Ezkeisac/chrome-subwoofer/README-chrome-draft.md

The chrome cabinet in the studio, a monitor standing on it

# DIY chrome subwoofer bc Everything is chrome in the future

Building a subwoofer for my home studio. A ten-inch driver, a sealed cabinet, a mirror
finish, a monitor base.

**318 × 661 × 280 mm · $380**

Turn it. Switch to wireframe. There is no bracing.

```stl
solid enclosure
  facet normal 0.0000 0.0000 -1.0000
    outer loop
      vertex 128.50 -171.50 0.00
      vertex 159.00 -128.90 0.00
      vertex 159.00 -171.50 0.00
    endloop
  endfacet
  facet normal 0.0000 0.0000 -1.0000
    outer loop
      vertex 128.50 -171.50 0.00
      vertex 124.12 -138.24 0.00
      vertex 159.00 -128.90 0.00
    endloop
  endfacet
  facet normal 0.0000 0.0000 -1.0000
    outer loop
      vertex 124.12 -138.24 0.00
      vertex 159.00 -79.70 0.00
      vertex 159.00 -128.90 0.00
    endloop
  endfacet
  facet normal 0.0000 0.0000 -1.0000
    outer loop
      vertex 124.12 -138.24 0.00
      vertex 111.28 -107.25 0.00
      vertex 159.00 -79.70 0.00
    endloop
  endfacet
  facet normal 0.0000 0.0000 -1.0000
    outer loop
      vertex 111.28 -107.25 0.00
      vertex 159.00 -12.50 0.00
      vertex 159.00 -79.70 0.00
    endloop
  endfacet
  facet normal 0.0000 0.0000 -1.0000
    outer loop
      vertex 111.28 -107.25 0.00
      vertex 90.86 -80.64 0.00
      vertex 159.00 -12.50 0.00
    endloop
  endfacet
  facet normal 0.0000 0.0000 -1.0000
    outer loop
      vertex 90.86 -80.64 0.00
      vertex 159.00 103.90 0.00
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

MDF is porous and its routed edges more so. Unsealed, it absorbs unevenly and telegraphs
its fibre through any film laid over it. Each coat fills that structure. Each sanding
removes what the coat raised. What remains is flat, sealed and non-absorbent.

The cabinet after priming and before vinyl: white primer on the sides, bare MDF on the baffle around the rebated aperture

Preparation is the operation. The wrap is the short step at the end: VViViD DECO65, cut
from the roll in pieces and fitted at the joints.

On a specular finish a seam is permanent. On a corner, where the surface already turns
away, it reads as an edge. Forty millimetres onto a flat face, the same seam reads as a
defect.

</details>

<details open>
<summary>The shape</summary>

A monitor stands on it. That fixed the footprint before any acoustic decision was made,
and left height as the only dimension free to solve.

An enclosure normally begins with a volume and arrives at proportions. This one runs the
other way. The footprint fixes the cross-section. **The shape leads and the volume must
follow.** Two dimensions imposed, one to solve.

The answer is a column more than twice as tall as it is wide. The same volume, unconstrained,
is a cube.

The footprint here is a Realistic Nova 7B's. Another monitor is another footprint, and
the height is solved again.

```bash
python3 calculations/derive_box.py
```

</details>

<details>
<summary>What you need</summary>

| | | |
|---|---|---:|
| GRS 10SW-4HE | 10-inch subwoofer, 4 ohm | $61.98 |
| MDF panel × 2 | 3/4 in × 4 ft × 8 ft | $97.96 |
| SPA300-D | 300 W plate amplifier | $167.98 |
| VViViD DECO65 | chrome vinyl, 20 ft × 11.8 in | $11.98 |
| RCA Y cable | subwoofer feed | $7.99 |
| Speaker wire | 16 AWG, 9.14 m | $9.95 |
| | **Total** | **$357.84** |

Fasteners, adhesive, primer and sealant are not costed.

Hand-held power tools, a compact router on a circle-cutting jig, clamps. No table saw. No
router table.

| | mm | in |
|---|---:|---:|
| External width × height × depth | 318 × 661 × 280 | 12.52 × 26.02 × 11.02 |
| Internal width × height × depth | 280 × 623 × 242 | 11.02 × 24.53 × 9.53 |
| Wall thickness | 19 | 0.75 |
| Driver flange diameter | 257 | 10.12 |
| Rebate depth | 6 | 0.24 |
| Through-hole diameter | 233 | 9.17 |

</details>

<details>
<summary>The cabinet</summary>

**Wear respiratory and eye protection throughout. MDF dust is a recognised hazard.**

Two sheets of 19 mm MDF. Set out the driver aperture with a pivot and rule. Cut it with
the router on the circle jig.

The driver aperture marked on the baffle, with the pivot at its centre, before routing

Rebate the aperture: a shallow shoulder concentric with the through-hole, so the 257 mm
flange seats flush. A jigsaw gives neither the radius nor the shoulder.

Glue and clamp the joints for **72 hours**. A sealed alignment is valid only if the
enclosure is airtight, and at this panel size a joint left to cure under its own weight
will creep.

**No internal bracing.** `DISCUSSION.md` §6.2 establishes that none is required.

</details>

<details>
<summary>The hook-up</summary>

The receiver's rear panel as wired, with the subwoofer on the SUB WOOFER RCA output

Drive it from the receiver's SUB WOOFER output. **That places two low-pass filters in
series**, the receiver's and the plate amplifier's, and their slopes sum. What is
measured here is the pair.

The pair is fourth order, −3 dB at 57 Hz, measured. The amplifier's dial deconvolves to
about 62 Hz against a target of 60, if the receiver's fixed stage is second order at
90 Hz. The manual gives the frequency and not the slope.

Two sources, two inputs. The DJ controller on CD. The record player on DVD.

The receiver is wired for more than it is asked. Mains on FRONT A, two surrounds, a booth
monitor on CENTER, the subwoofer on SUB WOOFER. With processing off, a stereo source
reaches the mains and the subwoofer and nothing else. In an upmixing mode the receiver
spreads either input across every channel, and the bass it redirects reaches the
subwoofer by a route not measured here.

</details>

<details>
<summary>The sound</summary>

**39.09 L · 36.2 Hz predicted · Q 0.799 predicted**

Q sweep: the response curve rising into its peak as the handle travels 0.50 to 1.20

<!-- To replace the animation with a real video: generate an .mp4, then drag it into
     any GitHub comment box or the README web editor. GitHub returns a signed asset URL
     and inserts the tag for you. The URL is not a committed file and cannot be written
     from a script, which is why the GIF is the default here.
<video src="https://github.com/user-attachments/assets/REPLACE-ME" autoplay loop muted playsinline></video>
-->

A sealed enclosure is a second-order high-pass. Two numbers govern it:

$$H(s) = \frac{s^{2}}{s^{2} + \dfrac{s}{Q_{tc}} + 1}$$

The handle runs 0.50 to 1.20. Butterworth is the tick at 0.707: maximally flat,
*F*<sub>3</sub> exactly at *F*<sub>c</sub>. This build is the tick at a predicted
**0.799**. It peaks before it rolls off.

That was accepted, not corrected. A small room adds low-frequency gain of its own, and a
gently rolling response meets that gain more predictably than a flat anechoic one.

```bash
python3 scripts/model.py selftest
python3 scripts/sweep_qtc.py
```

</details>

<details>
<summary>How it was measured</summary>

<picture>
  <source media="(prefers-color-scheme: dark)" srcset="images/response-dark.svg">
  Measured response against the sealed-alignment prediction and the filter chain, 12 to 200 Hz
</picture>

Prediction and measurement agree to **3.65 dB** mean absolute error over 20–80 Hz. The box
model and the filter chain together agree to **1.19 dB** over 45–110 Hz.

Stepped sine, not a sweep. Playback and capture ran on separate devices sharing no clock,
and a sweep assumes the two can be aligned in time. Each tone is an independent
observation at a frequency known exactly. There is no timeline for drift to corrupt.

The instrument is an uncalibrated recorder. Every curve here is **relative**. Spectral
shape is available. Absolute sound pressure is not.

`scripts/METHOD.md` carries the window lengths, the manifest, the single-bin extraction
and the two alignment failures that produced it.

```bash
python3 scripts/analyse_response.py selftest
```

</details>

<details>
<summary>What is still unexplained</summary>

Between 32 and 56 Hz, measurement exceeds prediction by about 3 dB. Three candidates: the
published Thiele–Small parameters do not describe this specimen; boundary reinforcement,
the cabinet being against a wall; or non-flat microphone response.

**None is eliminated by the present data.** The residual is a maximum centred near
*F*<sub>c</sub>, not a monotonic rise toward low frequency, which weakly favours the first
without establishing it.

The driver parameters were never measured. That is the first thing to do differently.

</details>

---

The record: [`RECORD.txt`](RECORD.txt)

Documentation CC BY-SA 4.0, code MIT — [`LICENSE`](LICENSE).
