Ezkeisac/chrome-subwoofer/images/finished-in-situ.jpeg

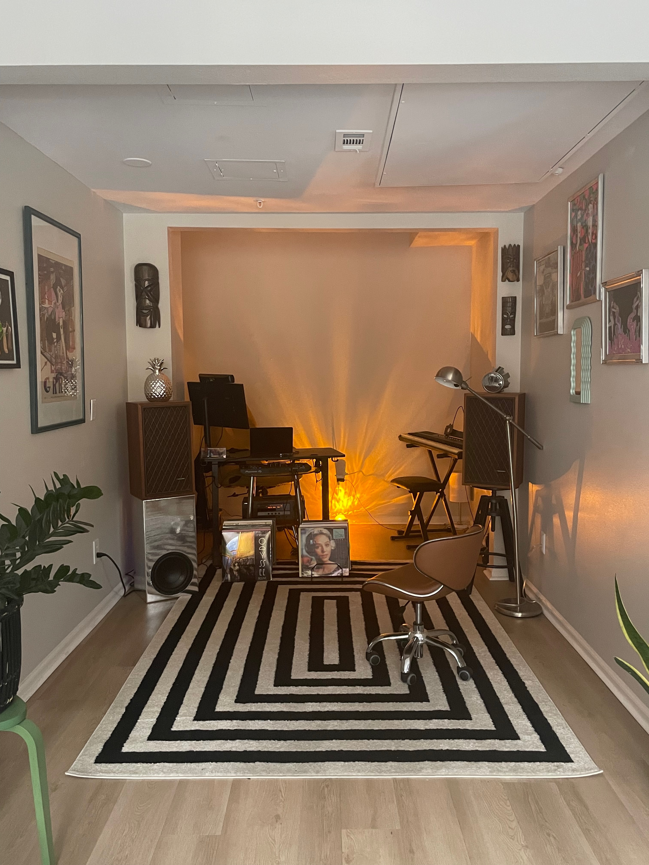
images/finished-in-situ.jpeg
