Ezkeisac/chrome-subwoofer/images/receiver-rear.jpeg

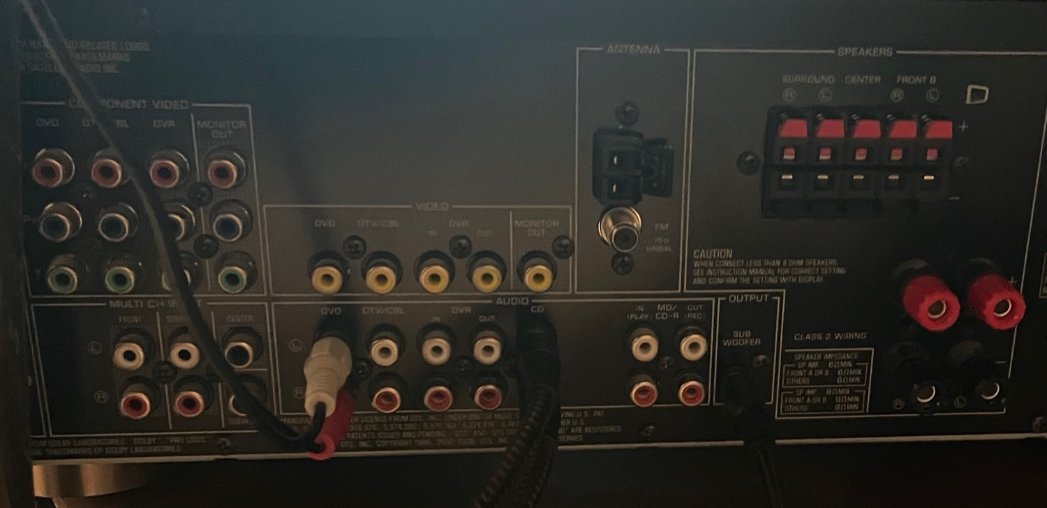
images/receiver-rear.jpeg
