Ezkeisac/chrome-subwoofer/calculations/materials-cost.csv

item | description | quantity | unit_price_usd | ext_price_usd
GRS 10SW-4HE | 10 inch subwoofer 4 ohm | 1 | 61.98 | 61.98
MDF panel | MDF 3/4 in x 4 ft x 8 ft | 2 | 48.98 | 97.96
SPA300-D | 300 W plate amplifier | 1 | 167.98 | 167.98
VViViD DECO65 | chrome vinyl 20 ft x 11.8 in | 1 | 11.98 | 11.98
RCA Y cable | subwoofer feed | 1 | 7.99 | 7.99
Speaker wire | 16 AWG 9.14 m | 1 | 9.95 | 9.95
