Ezkeisac/chrome-subwoofer/images/enclosure.stl

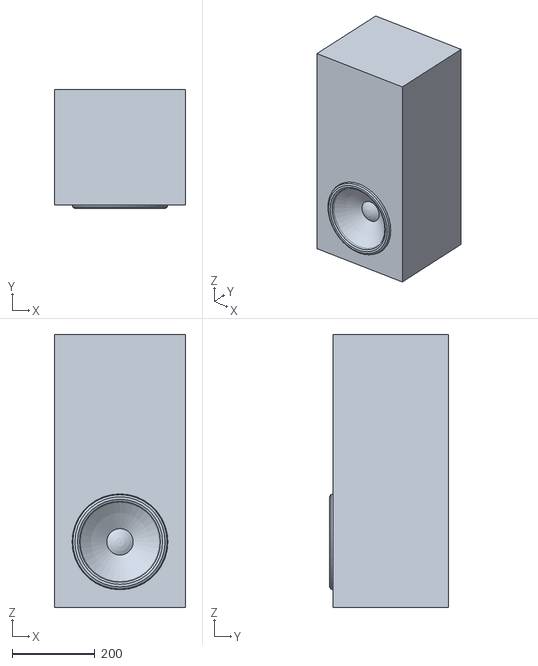
[picture p9: CAD file, 2026-11-07]
images/enclosure.stl
318.0 x 288.6 x 661.0
