Ezkeisac/chrome-subwoofer/images/construction-marking.jpeg

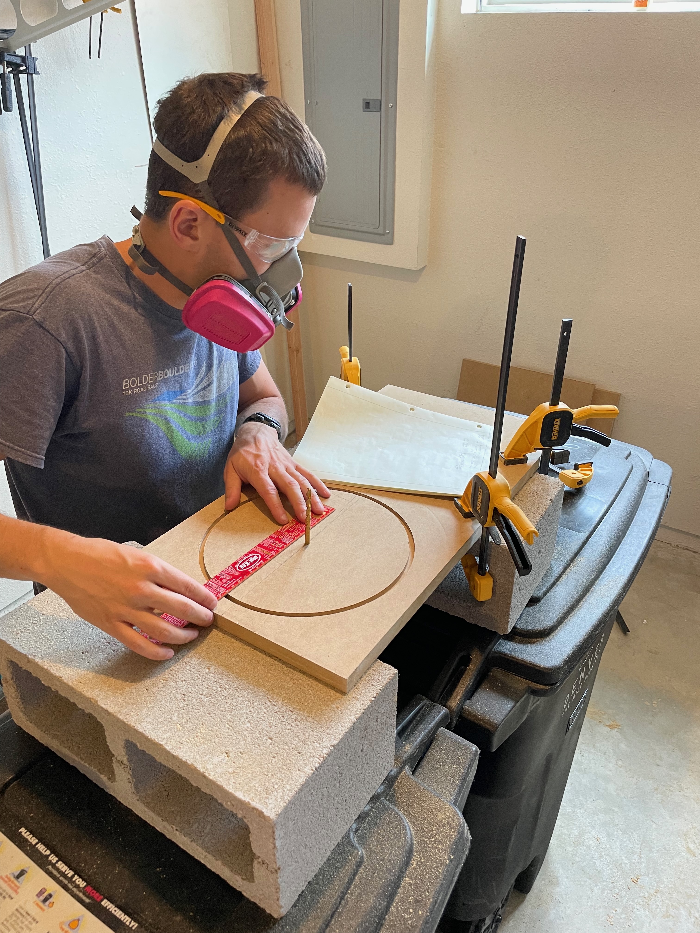
images/construction-marking.jpeg
