Ezkeisac/chrome-subwoofer/images/construction-routing.jpeg

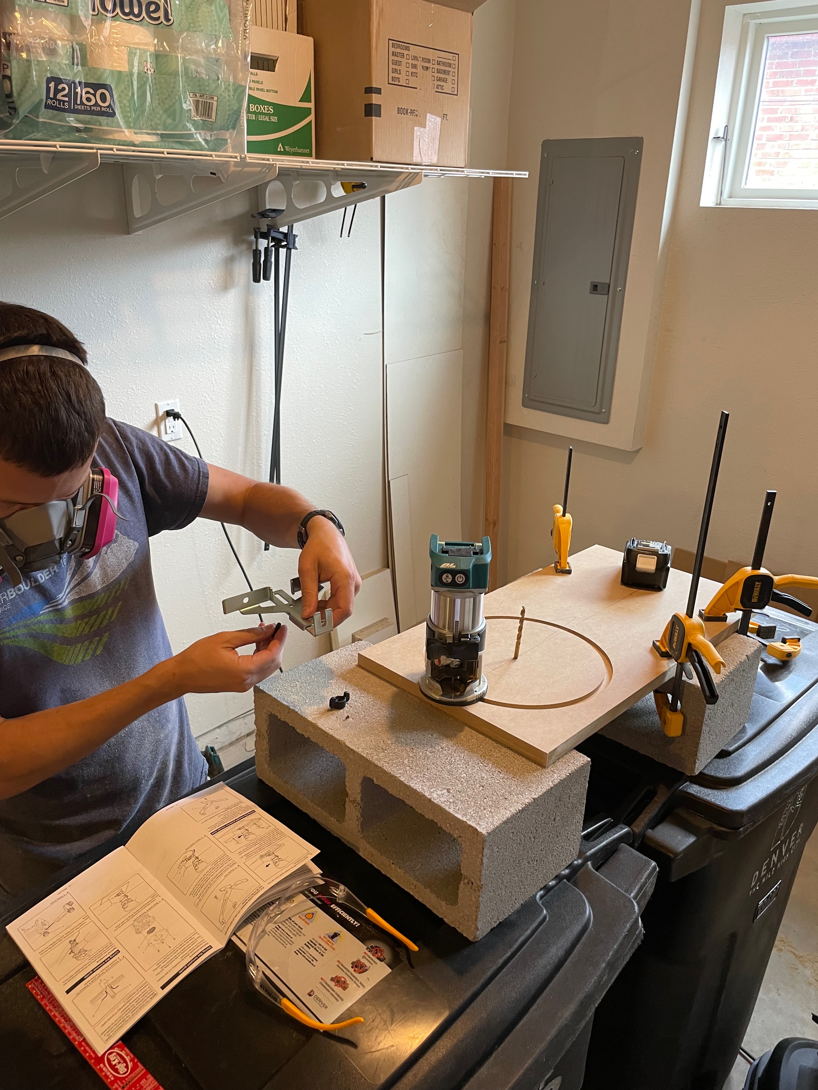
images/construction-routing.jpeg
