Ezkeisac/chrome-subwoofer/calculations/measured-vs-predicted.csv

hz | measured_db | predicted_db | difference_db | filter_db
12.8 | -28.73 | -19.61 | -9.12 | 0.00
14.2 | -18.73 | -17.98 | -0.75 | 0.00
15.8 | -22.10 | -15.95 | -6.16 | 0.00
17.6 | -20.71 | -14.33 | -6.38 | 0.00
19.5 | -17.43 | -12.31 | -5.11 | 0.00
21.6 | -9.91 | -10.73 | +0.81 | 0.00
24.0 | -17.09 | -8.79 | -8.30 | 0.00
26.7 | -10.06 | -7.29 | -2.77 | -0.01
29.6 | -5.39 | -5.54 | +0.14 | -0.02
32.9 | -1.09 | -4.26 | +3.17 | -0.05
36.5 | 0.44 | -2.88 | +3.32 | -0.12
40.6 | 2.42 | -1.98 | +4.40 | -0.28
45.0 | 0.77 | -1.11 | +1.89 | -0.61
50.0 | 1.38 | -0.62 | +2.00 | -1.31
55.5 | 3.12 | -0.21 | +3.33 | -2.58
61.6 | -2.37 | 0.03 | -2.40 | -4.58
68.4 | -3.96 | 0.13 | -4.09 | -7.26
76.0 | -9.57 | 0.19 | -9.76 | -10.41
84.4 | -11.31 | 0.21 | -11.52 | -13.81
93.7 | -11.21 | 0.20 | -11.41 | -17.35
104.0 | -17.75 | 0.19 | -17.94 | -20.94
115.5 | -23.83 | 0.17 | -23.99 | -24.55
128.3 | -42.01 | 0.15 | -42.15 | -28.18
142.4 | -44.84 | 0.12 | -44.97 | -31.81
158.1 | -48.79 | 0.11 | -48.90 | -35.45
175.6 | -58.88 | 0.09 | -58.97 | -39.08
194.9 | -55.69 | 0.07 | -55.77 | -42.72
