Ezkeisac/chrome-subwoofer/(commit log)

2026-09-18 Chrome subwoofer: design, construction and acoustic verification
    Standalone public repository. Everything the paper references now sits beside it
    so relative links resolve: calculations, scripts, data and images.
    Rewritten in academic register - structured abstract, nomenclature table,
    numbered sections, numbered figures with captions, references.
    Abstract corrected per the builder: two sheets of MDF, and the Tascam DR-05
    named as the measuring instrument. The impedance-rig account is removed; the
    paper now simply states that Thiele-Small parameters are the manufacturer's
    published figures, taken from the driver manual, and flags them wherever they
    propagate.
    Two construction photographs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
2026-09-18 Condense the paper; anonymise figures; correct links and the signal path
    Synthesised throughout - abstract, nomenclature, design, construction, method and
    discussion all tightened without dropping a finding or a number. 453 lines to 386.
    Identity: the two construction photographs are replaced by one crop showing the
    workpiece, router and jig with no person in frame. Cropping rather than blurring
    was the cheaper fix, and the routing shot carries the marked circle as well, so
    one figure does the work of two - which also serves the concision.
    Section 2 now links the individual calculation files rather than the directory,
    which is what failed to resolve. A link in 6.2 read calculations/panel_m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
2026-09-18 Correct the finishing sequence: priming was the missing step
    Section 3.2 recorded sanding straight to vinyl. It was sanding, then THREE COATS
    OF PRIMER sanded between coats, then vinyl - and the primer is what makes a
    mirror finish possible on MDF at all. The board is porous and its routed edges
    more so; an unsealed surface telegraphs its own fibre through any film laid over
    it. Successive coats fill that structure and sanding between removes what each
    coat raises.
    This also corrects Figure 2, captioned as a part-wrapped cabinet. The white
    coating is the third primer coat, not vinyl. The baffle is bare MDF because it
    had not been primed yet, not because the wrap had not reached it. The figu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
2026-09-18 Materials confirmed at two sheets, $357.84
    Quantity confirmed by the builder. The outstanding flag is removed and the
    schedule is tabulated in the paper rather than only in the CSV. Primer added to
    the uncosted list, since section 3.2 now records three coats of it.
2026-09-19 Restructure: methodology in the paper, numbers in the repository
    Sections 2 and 4 now explain method rather than recite values. Section 2 frames
    the design as an inverted problem - R3 fixes the footprint, so shape leads and
    volume follows, leaving a single degree of freedom - and sends every dimension,
    volume and driver parameter to calculations/. Section 4 explains why a stepped
    excitation removes the synchronisation assumption instead of working around it,
    and what an uncalibrated instrument can and cannot establish.
    Results is now a figure. plot_response.py generates both images/response.svg and
    calculations/measured-vs-predicted.csv from the same data, so the plot and the
    table behind i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
2026-09-21 Add the sealed-alignment transfer function; drop the vinyl material note
    Section 2.5 gives the second-order high-pass in normalised form and the magnitude
    that Figure 5 plots, and makes the point the paper leans on elsewhere: only Fc and
    Qtc appear, which is what lets section 2.1 treat the design as a single-variable
    problem and still predict behaviour.
    Cross-referenced to model.py, whose selftest verifies the Butterworth identity,
    the 12 dB per octave asymptote and the flat passband rather than assuming them.
2026-09-23 Restore results to the abstract, framed as requirements met
    The abstract closes on the verdict against R1-R6 rather than on a list
    of findings: footprint, finish, integration and crossover satisfied,
    low-frequency output supported but not absolutely confirmed, and the
    3.65 dB agreement figure.
2026-11-06 Documentation rework, and a README draft under the chrome narrative
    Two bodies of work. The first was asked for directly; the second is a proposal and
    touches nothing that is live.
    DOCUMENTATION
    Sections 1.1 and 1.2 justify the two requirements that look like numbers chosen by
    taste. 35 Hz is where the programme material stops: bass guitar open E is 41.2 Hz, a
    five-string low B 30.9 Hz, and vinyl cutting attenuates below roughly 30 Hz anyway.
    Going lower is expensive in one currency only -- under R3 volume buys height, and the
    cabinet is a stand, so R1 and R3 trade against each other along the single free
    dimension. 60 Hz is where the mains run out, and the crossover section st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
2026-11-07 README draft: visual to technical, in the chrome voice
    The draft now runs from the object to the record: the banner and title, the model, the
    chrome, the shape, parts, the cabinet, the hook-up, the sound, the measurement, and what
    is still unexplained. A parts list, the MDF dust warning and seam placement come across
    from the paper. The R-numbers go, since the draft never defined them. README.md stays
    the paper until the owner decides where it moves.
    Wording corrections from checking the draft against the paper: 36.2 Hz and Q 0.799 are
    labelled predicted, "gently rising" returns to the paper's "gently rolling", and
    "clear of the filter chain" is dropped because the chain is already near -2.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
2026-11-07 Stand the model up for GitHub's viewer
    GitHub's STL viewer has z up. The model was built y up, so it opened lying on its back
    with the driver facing the grid. Only visible once the branch was on GitHub: the local
    preview uses its own viewer. Turned with a true rotation, and the preview turns it back.
2026-11-07 Show the chrome on GitHub: a rendered turntable
    GitHub's STL viewer is one flat blue and cannot be changed, so the finish is computed and
    shipped as an image. render_chrome.py draws the same geometry as images/enclosure.stl, a
    mirror reflecting a bright room, with the vinyl's waver and the driver in black rubber.
    Standard library only.
    The GIF sits under the goal text. The interactive model moves to its own section.
    The hook-up names the record player's built-in phono stage: the receiver has none.
2026-11-07 Keep the model's section open
    GitHub's STL viewer draws nothing when it starts inside a collapsed section: it gets no
    size to work with, and opening the section afterwards leaves it blank.
